uCAN-LIN/LINRelay/README.md

# LINRelay
LIN(Local Interconnect Network) relay project, see [ucandevices](https://ucandevices.github.io) web page for full info.
