uCAN-LIN/LINRelay/(commit log)

2018-04-06 Remap PIC-KIT connector
    [lin_bb.kicad_pcb, lin_bb.sch]
2018-04-06 Embedded init
    [lin_bb.kicad_pcb, lin_bb.sch]
2018-05-26 Mosfet update + panels
    [combined.GKO, combined.gts, lin_bb-B.Adhes.gbr, lin_bb-B.CrtYd.gbr, lin_bb-B.Cu.gbl, lin_bb-B.Cu.gbr, lin_bb-B.Fab.gbr, lin_bb-B.Mask.gbs]
2018-07-18 LIN relay commands add
2018-07-25 ucan status add
    [lin_bb.sch]
